mike-rankin/ESP32_USB-C_Power_Supply/Images/Board.jpg

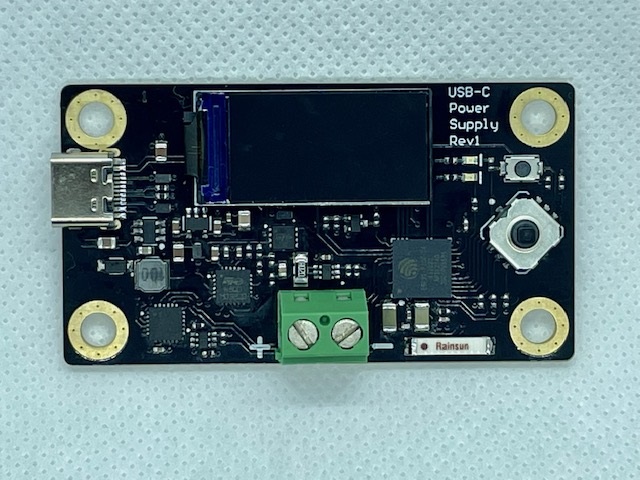
Images/Board.jpg
