mike-rankin/ESP32_USB-C_Power_Supply/Images/usbc.jpg

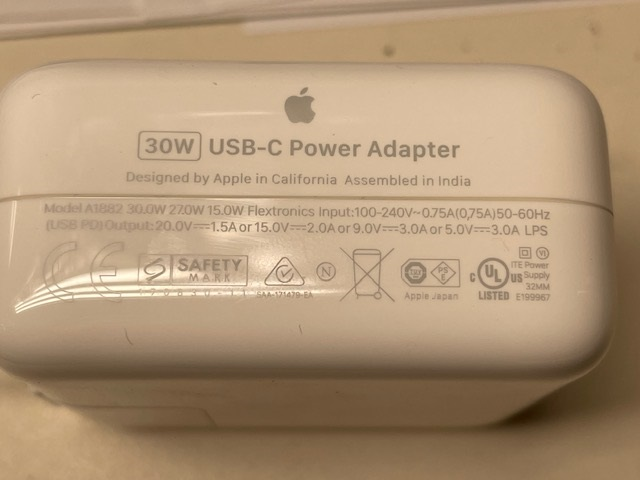
Images/usbc.jpg
