mike-rankin/ESP32_USB-C_Power_Supply/Images/Hardware.png

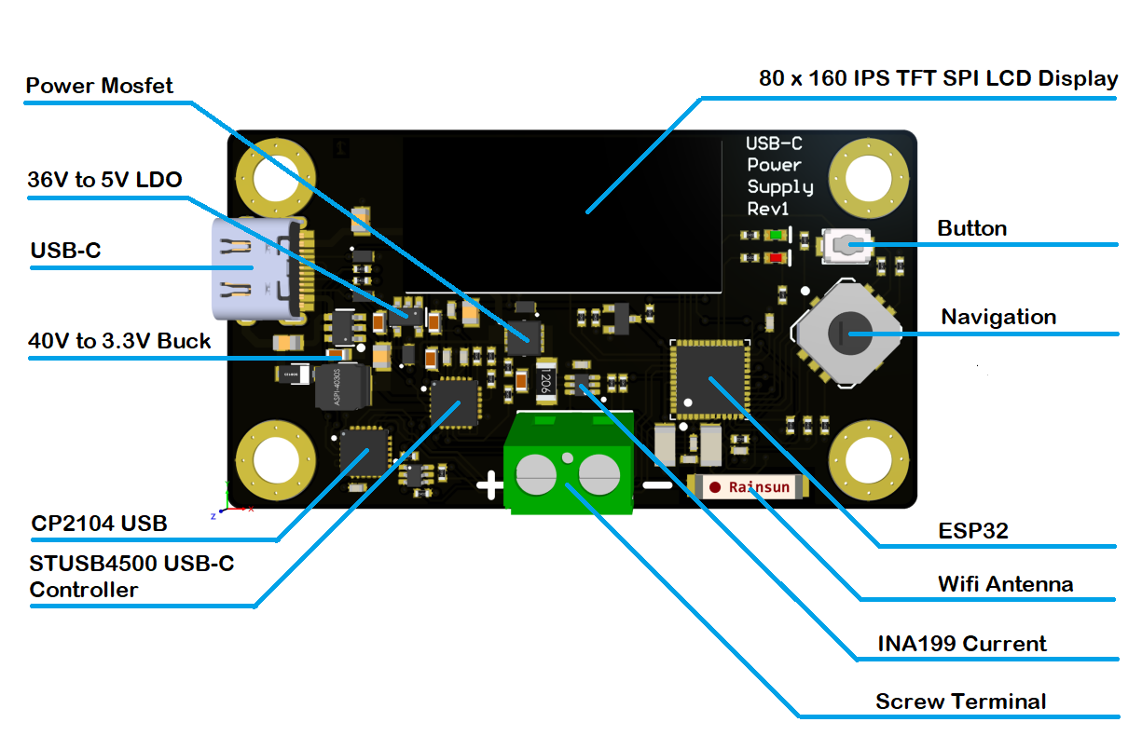
Images/Hardware.png
