mike-rankin/ESP32_USB-C_Power_Supply/PCB/Parts_List_Rev1.2.xlsx

Designator | Quantity | Vendor | Description | Manufacturer | Value | Part_Number | Part_Footprint
A1 | 1 | LCSC | Antenna Chip 2.4Gig | Rainsun | Chip Antenna | C99665
C1, C5, C11 | 3 | LCSC | CAP 1uF 0402 | Murata | 1uF | C77007 | 0402
C2, C12, C14 | 3 | LCSC | CAP 4.7uF 50V 0805 | Murata | 4.7uF, 50V | C162320 | 0805
C3, C9, C10 | 3 | LCSC | CAP 1uF 50V 0603 | Yageo | 1uF, 50V | C559769 | 0603
C4, C13 | 2 | LCSC | CAP 0.1uF 50V 0603 | Murata | 0.1uF, 50V | C77055 | 0603
C6, C16, C18, C20 | 4 | LCSC | CAP 0.1uF 0402 | Murata | 0.1uF | C126523 | 0402
C7, C8 | 2 | LCSC | CAP 100uF 6.3V 1206 | Taiyo Yuden | 100uF | C87164 | 1206
C15 | 1 | LCSC | CAP 10uF 0805 | Samsung | 10uF | C307520 | 0805
C17 | 1 | LCSC | CAP 1.5pF 0402 | Dafron | 1.5pF | C147344 | 0402
D1, D2, D3, D4 | 4 | LCSC | DIODE TVS 22V 41V 400W 2-UDFN | ST MICRO | ESDA25P35 | C1974707 | 2-UDFN
D5 | 1 | LCSC | DIODE SCHOTTKY 30V 500MA SOD-123 | Micro | MBR0530T1G | C82046 | SOD-123
D6 | 1 | LCSC | LED Green 0402 | Lite-On | Green Led | C74338 | 0402
D7 | 1 | LCSC | LED Red 0402 | Lite-On | Red Led | C364556 | 0402
J1 | 1 | LCSC | CONN RECPT USB-C | KHE | USB-C | C165948 | SMT
J2 | 1 | Digi-Key | TERM,SCREW,2POS,RoHS | TE |  | 282837-2
L1 | 1 | LCSC | INDUCTOR 6.8uH 20% 4mmx4mm | PROD TECH | 6.8uH | C436648 | 4mmx4mm
Q1 | 1 | Digi-Key | MOSFET P-CH 30V 6A 8-PowerVDFN | ST MICRO | STL6P3LLH6 | STL6P3LLH6 | 8-PowerVDFN
Q2 | 1 | LCSC | TRANSISTOR NPN GP 40V SC-70 | Changjiang | MMST3904 | C54879 | SC-70
Q3 | 1 | LCSC | TRANS 2NPN 44V 0.1A SC-70-6 | Changjiang | BC847S | C148112 | SC-70-6
R1 | 1 | LCSC | RES 100K 0402 | Uniroyal Elec | 100K | C25741 | 0402
R2 | 1 | LCSC | RES 4.7K 0402 | Panasonic | 4.7K | C427244 | 0402
R3 | 1 | LCSC | RES 100R 0402 | Panasonic | 100 | C413063 | 0402
R4 | 1 | LCSC | RES 22K 0402 | LIZ Elec | 22K | C100310 | 0402
R5, R6, R18 | 3 | LCSC | RES 1K 0402 | Yageo | 1K | C106235 | 0402
R7, R10, R11, R12, R13, R14, R15, R19, R21, R22 | 10 | LCSC | RES 10K 0402 | Guangdong | 10K | C258091 | 0402
R8, R9, R23 | 3 | LCSC | RES 2K 0402 | LIZ Elec | 2K | C100291 | 0402
R16, R17, R20 | 3 | LCSC | RES 22R 0402 | Panasonic | 22R | C413049 | 0402
R24 | 1 | LCSC | RES 100K 0402 | Uniroyal Elec | 100K | C25741 | 0402
R25 | 1 | LCSC | RES 10K 0402 | Guangdong | 10K | C258091 | 0402
R26 | 1 | LCSC | RES 0.1R 1210 | Uniroyal | 0.1R | C270892 | 1210
S2 | 1 | LCSC | Switch SMD,3x4x2.5mm | Xunpu | Pushbutton | C455281 | SMD
S3 | 1 | LCSC | DX_Navigation Switch | Bright | SMD Multi-Directional Switch | C722955
U1 | 1 | LCSC | IC USB-C CONTROLLER 24QFN | ST Micro | STUSB4500QTR | C2678061 | 24QFN
U2 | 1 | LCSC | WIFI/Bluetooth, QFN-48 7x7 | Espressif | ESP32-PICO-D4 | C193707 | QFN48
U3 | 1 | LCSC | IC REG BUCK 3.3V 0.6A SOT23-6 | Texas Instruments | LMR16006YQ3 | C2070613 | SOT23-6
U4 | 1 | LCSC | IC BRIDGE USB TO UART 24QFN | Silicon Labs | CP2104N | C47742 | 24QFN
U5 | 1 | Digi-Key | IC LDO 5V 28V 0200mA SOT23-5 | Richtek | RT9069-50GB | RT9069-50GB | SOT23-5
U6 | 1 | Digi-Key | IC CURRENT MONITOR 1% SOT23-8 | Texas Instruments | INA219 | INA219AIDCNR | SOT-23-8
X2 | 1 | BuyDisplay | 0.96 INCH TFT GLASS COLOR | BuyDisplay | TFT 0.96 Inch | ER-TFT0.96-1
