mike-rankin/ESP32_USB-C_Power_Supply/PCB/Schematic_Rev1.2.pdf

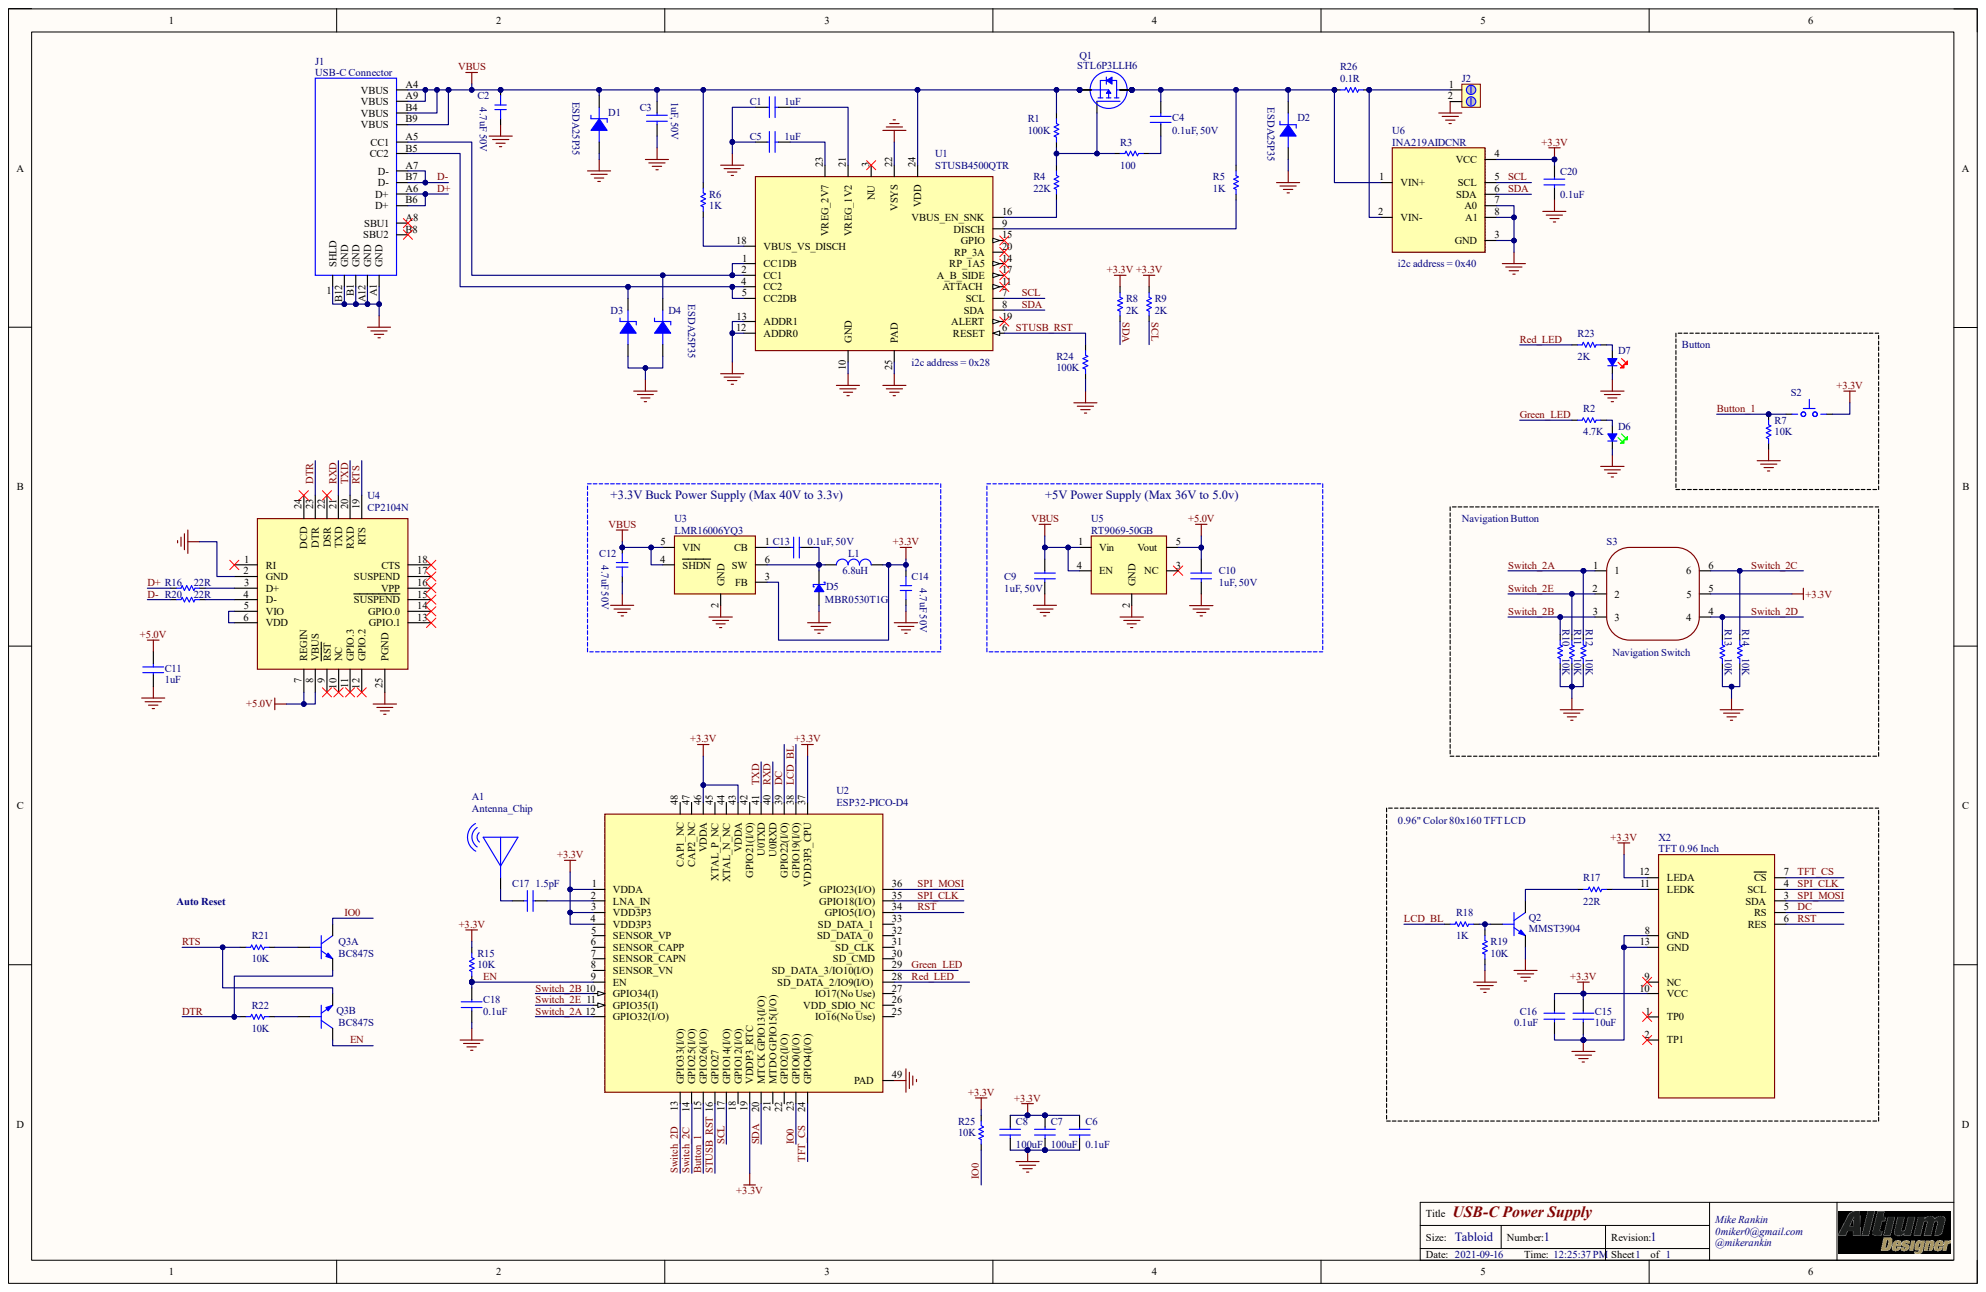
[picture p4: page 1]

+3.3V Buck Power Supply (Max 40V to 3.3v)

+5V Power Supply (Max 36V to 5.0v)
