mike-rankin/ESP32_USB-C_Power_Supply/PCB/Parts_Placement_Rev1.2.pdf

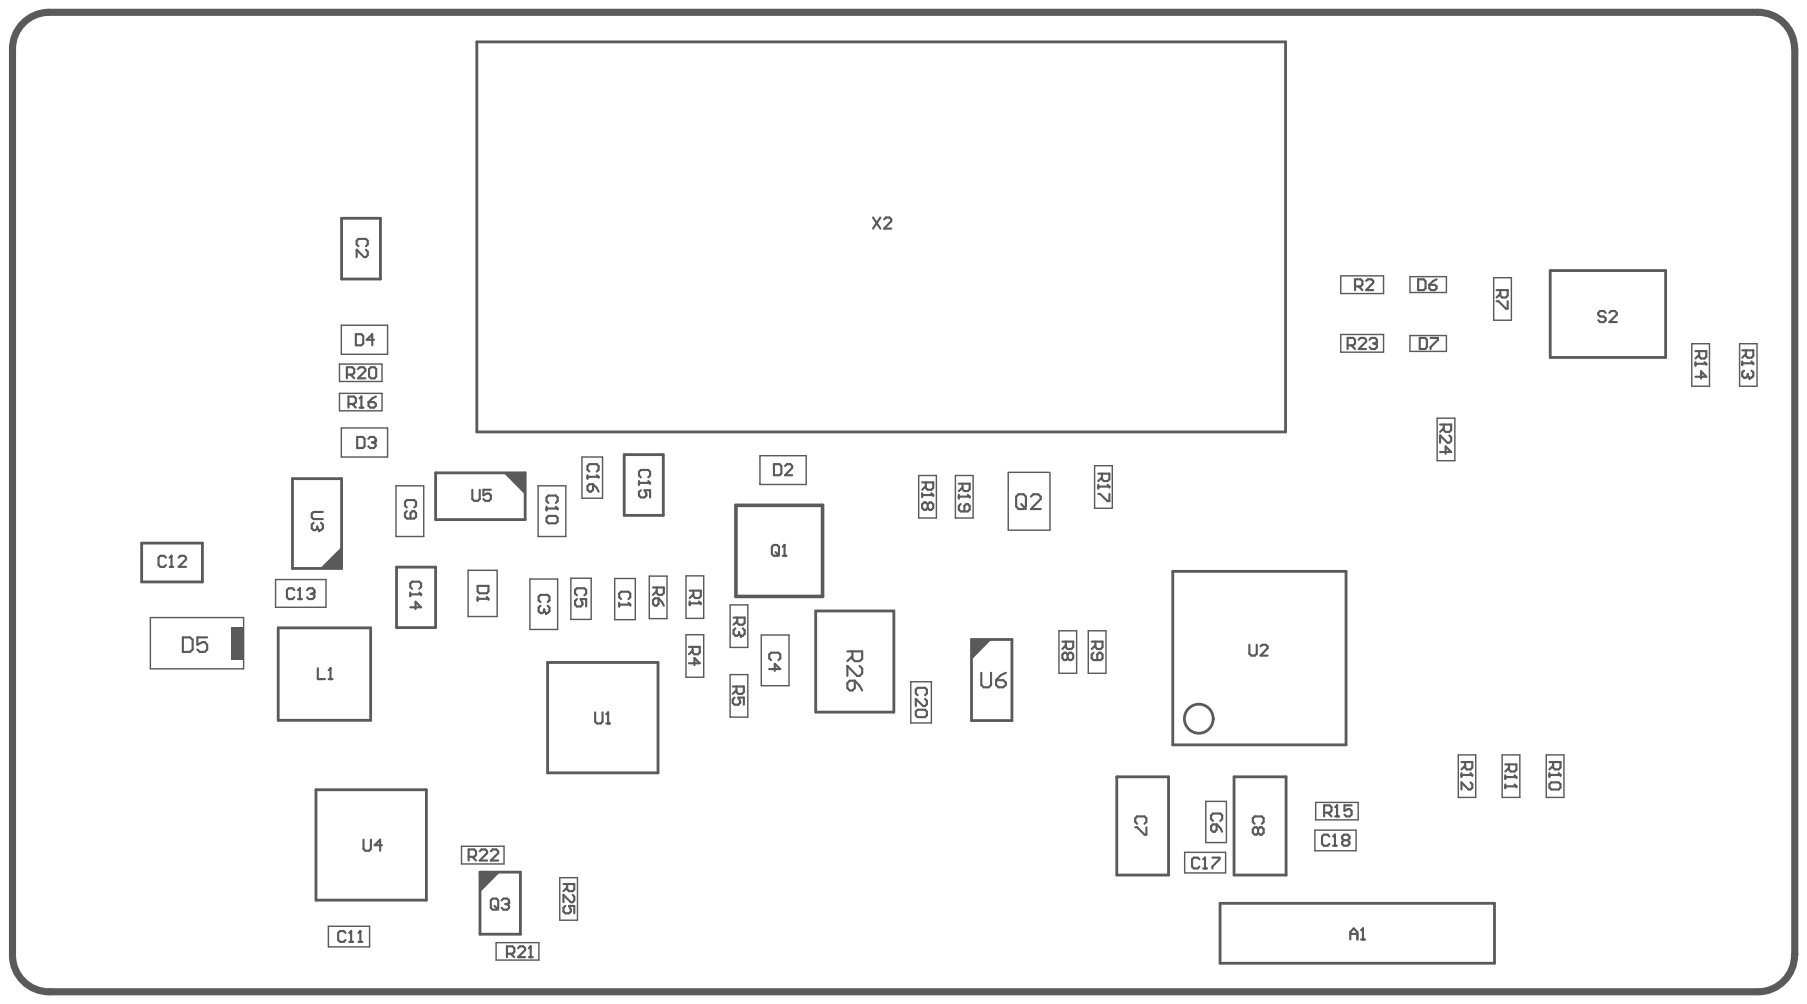
[picture p5: page 1]
