mike-rankin/ESP32_USB-C_Power_Supply/(threads)

Thread 2 (2022-01-10):

Software Fixes

pb4ugoout, 2022-01-10:
Have you been able to resolve the problems you had with the software? You mentioned that someone else wrote the code but you "damaged" it and it was a work in progress? I'm planning on having some PCBs made and purchasing some parts so that I could make a few of these for myself and coworkers.

mike-rankin, 2022-01-12:
The issues have been fixed and the project works much better now.

Closed 2022-01-13.
