mike-rankin/ESP32_USB-C_Power_Supply/Code/Hardware_Test/Orbitron_Bold_22.h

// Created by http://oleddisplay.squix.ch/ Consider a donation
// In case of problems make sure that you are using the font file with the correct version!
const uint8_t Orbitron_Bold_22Bitmaps[] PROGMEM = {

  // Bitmap Data:
  0x00, // ' '
  0xEE,0xEE,0xEE,0xEE,0xEE,0xEE,0x0E,0xEE, // '!'
  0xEE,0xEE,0xEE,0xEE, // '"'
  0x07,0x0E,0x03,0x87,0x01,0xC7,0x01,0xC3,0x8F,0xFF,0xF7,0xFF,0xF8,0x70,0xE0,0x38,0x70,0x1C,0x30,0x1C,0x38,0x3F,0xFF,0x9F,0xFF,0xC3,0x0E,0x03,0x87,0x01,0xC3,0x81,0xE3,0x80, // '#'
  0x03,0x80,0x03,0x80,0x7F,0xFC,0xFF,0xFE,0xFF,0xFE,0xE3,0x86,0xE3,0x80,0xE3,0x80,0xE3,0x80,0xFF,0xFE,0x7F,0xFE,0x1F,0xFE,0x03,0x86,0x03,0x86,0xE3,0x86,0xFF,0xFE,0xFF,0xFE,0x7F,0xFC,0x03,0x80,0x03,0x80, // '$'
  0x3C,0x00,0xC7,0xE0,0x1C,0xFF,0x03,0xCE,0x30,0x78,0xE3,0x0F,0x0E,0x33,0xE0,0xFF,0x7C,0x07,0xEF,0x80,0x01,0xE7,0x80,0x3C,0xFC,0x07,0x9F,0xE1,0xF1,0x8E,0x3E,0x18,0xE3,0x81,0x8E,0x30,0x1F,0xC2,0x00,0xFC, // '%'
  0x1F,0xFC,0x03,0xFF,0xE0,0x7F,0xFE,0x07,0x00,0xE0,0x70,0x0E,0x07,0x00,0x00,0x78,0x00,0x07,0xE0,0x00,0xFF,0x87,0x0E,0x7E,0x70,0xE1,0xFF,0x0E,0x07,0xF0,0xE0,0x1F,0x8F,0xFF,0xFE,0x7F,0xFE,0xE3,0xFF,0xE6, // '&'
  0xEE,0xEE, // '''
  0x33,0xBD,0xCE,0x73,0x9C,0xE7,0x39,0xCE,0x79,0xCE, // '('
  0xE7,0xBC,0x63,0x18,0xC6,0x31,0x8C,0x63,0x7B,0xDC, // ')'
  0x1C,0x03,0x83,0x76,0x7F,0xCF,0xFC,0x7E,0x0F,0x83,0xBC,0x77,0x04,0x40, // '*'
  0x1C,0x07,0x01,0xC3,0xFE,0xFF,0xBF,0xE1,0xC0,0x70,0x1C,0x00, // '+'
  0xEE,0xEE,0xEC, // ','
  0xFF,0xBF,0xEF,0xF8, // '-'
  0xEE,0xE0, // '.'
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
    {   824,  16,  16,  18,    1,  -16 }, // 'E'
    {   856,  16,  16,  17,    1,  -16 }, // 'F'
    {   888,  17,  16,  19,    1,  -16 }, // 'G'
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
};
const GFXfont Orbitron_Bold_22 PROGMEM = {
(uint8_t  *)Orbitron_Bold_22Bitmaps,(GFXglyph *)Orbitron_Bold_22Glyphs,0x20, 0x7E, 23};
