mike-rankin/ESP32_USB-C_Power_Supply/Code/Hardware_Test/Orbitron_Medium_16.h

// Created by http://oleddisplay.squix.ch/ Consider a donation
// In case of problems make sure that you are using the font file with the correct version!
const uint8_t Orbitron_Medium_16Bitmaps[] PROGMEM = {

  // Bitmap Data:
  0x00, // ' '
  0xDB,0x6D,0xB6,0xC3,0x60, // '!'
  0xF7,0xBC, // '"'
  0x0C,0x61,0x8C,0xFF,0xEF,0xFE,0x31,0x83,0x18,0x21,0x0F,0xFE,0x63,0x04,0x30,0xC6,0x00, // '#'
  0x0C,0x07,0xF8,0xFF,0xE8,0xC6,0x8C,0x08,0xC0,0xFF,0xCF,0xFE,0x0C,0x60,0xC6,0x8C,0x6F,0xFE,0xFF,0xC0,0xC0,0x0C,0x00, // '$'
  0x20,0x09,0xF0,0x32,0x20,0xE4,0x43,0x08,0x8C,0x0F,0x70,0x01,0xC0,0x07,0x7C,0x1C,0x8C,0x61,0x19,0x83,0x32,0x03,0xC0, // '%'
  0x3F,0x81,0xFF,0x8C,0x06,0x30,0x00,0xC0,0x01,0xC0,0x0D,0xC2,0x33,0xC8,0xC3,0xE3,0x03,0xCF,0xFF,0x9F,0xFA, // '&'
  0xDB,0x00, // '''
  0x2E,0xCC,0xCC,0xCC,0xCC,0xE6, // '('
  0x8C,0x66,0x66,0x66,0x66,0xEC, // ')'
  0x18,0x18,0x5E,0xFE,0x38,0x3C,0x66, // '*'
  0x10,0x10,0xFE,0xFE,0x10,0x10, // '+'
  0xDB,0x40, // ','
  0xFD,0xF8, // '-'
  0xD8, // '.'
  0x01,0x00,0x80,0xC0,0xC0,0x60,0x60,0x60,0x60,0x60,0x60,0x30,0x10,0x00, // '/'
  0x3F,0xCF,0xFE,0xC0,0x6C,0x0E,0xC3,0xAC,0x72,0xCE,0x2D,0xC2,0xF0,0x2E,0x02,0xFF,0xE7,0xFE, // '0'
  0x18,0xE3,0x9A,0x88,0x20,0x82,0x08,0x20,0x82, // '1'
  0x3F,0xCF,0xFE,0xC0,0x20,0x02,0x00,0x20,0x02,0xFF,0xEC,0x00,0xC0,0x0C,0x00,0xFF,0xEF,0xFE, // '2'
  0x3F,0x8F,0xFE,0xC0,0x60,0x06,0x00,0x63,0xFE,0x3F,0xE0,0x02,0x00,0x2C,0x02,0xFF,0xE7,0xFE, // '3'
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
    {   448,  11,  12,  13,    1,  -12 }, // 'E'
    {   465,  11,  12,  13,    1,  -12 }, // 'F'
    {   482,  12,  12,  14,    1,  -12 }, // 'G'
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
};
const GFXfont Orbitron_Medium_16 PROGMEM = {
(uint8_t  *)Orbitron_Medium_16Bitmaps,(GFXglyph *)Orbitron_Medium_16Glyphs,0x20, 0x7E, 16};
