mike-rankin/ESP32_USB-C_Power_Supply/(commit log)

2021-06-22 added image
    [Parts_List_Rev1.xlsx]
2021-07-23 updated bom
    [BOM_Rev1.xlsx, Parts_List_Rev1.xlsx]
2021-07-28 updated files
    [BOM_Rev1.xlsx, Parts_List_Rev1.xlsx]
2021-10-27 Update USB-C_Power.ino
    Updated PDO selection logic to actually disable the V_BUS pass FET - both on boot, and when PD values are changed.
    Tested - works.
2021-10-28 Update USB-C_Power.ino
    Updated logic to use PD0 as a non-active, default state.
    This fixes the persistent PDO profile issue, where the last loaded PDO config is present when re-connecting a USB-C PD source to the board.
    This change means that the board will default to no output - which is more suitable for this use case!
    [USB-C_Power.ino]
2021-10-28 Updated revision
    [Parts_List_Rev1.2.xlsx, Parts_List_Rev1.xlsx]
2022-01-19 Add files via upload
    Tom's updated code - with a 100-point Moving Average Filter.
